MouseBiteLabs/Genesis-Cartridges/README.md

# Genesis-Cartridges
A collection of Genesis/Mega Drive cartridge circuit boards
