MouseBiteLabs/Genesis-Cartridges/Advanced Flash/schematic_1-2.pdf

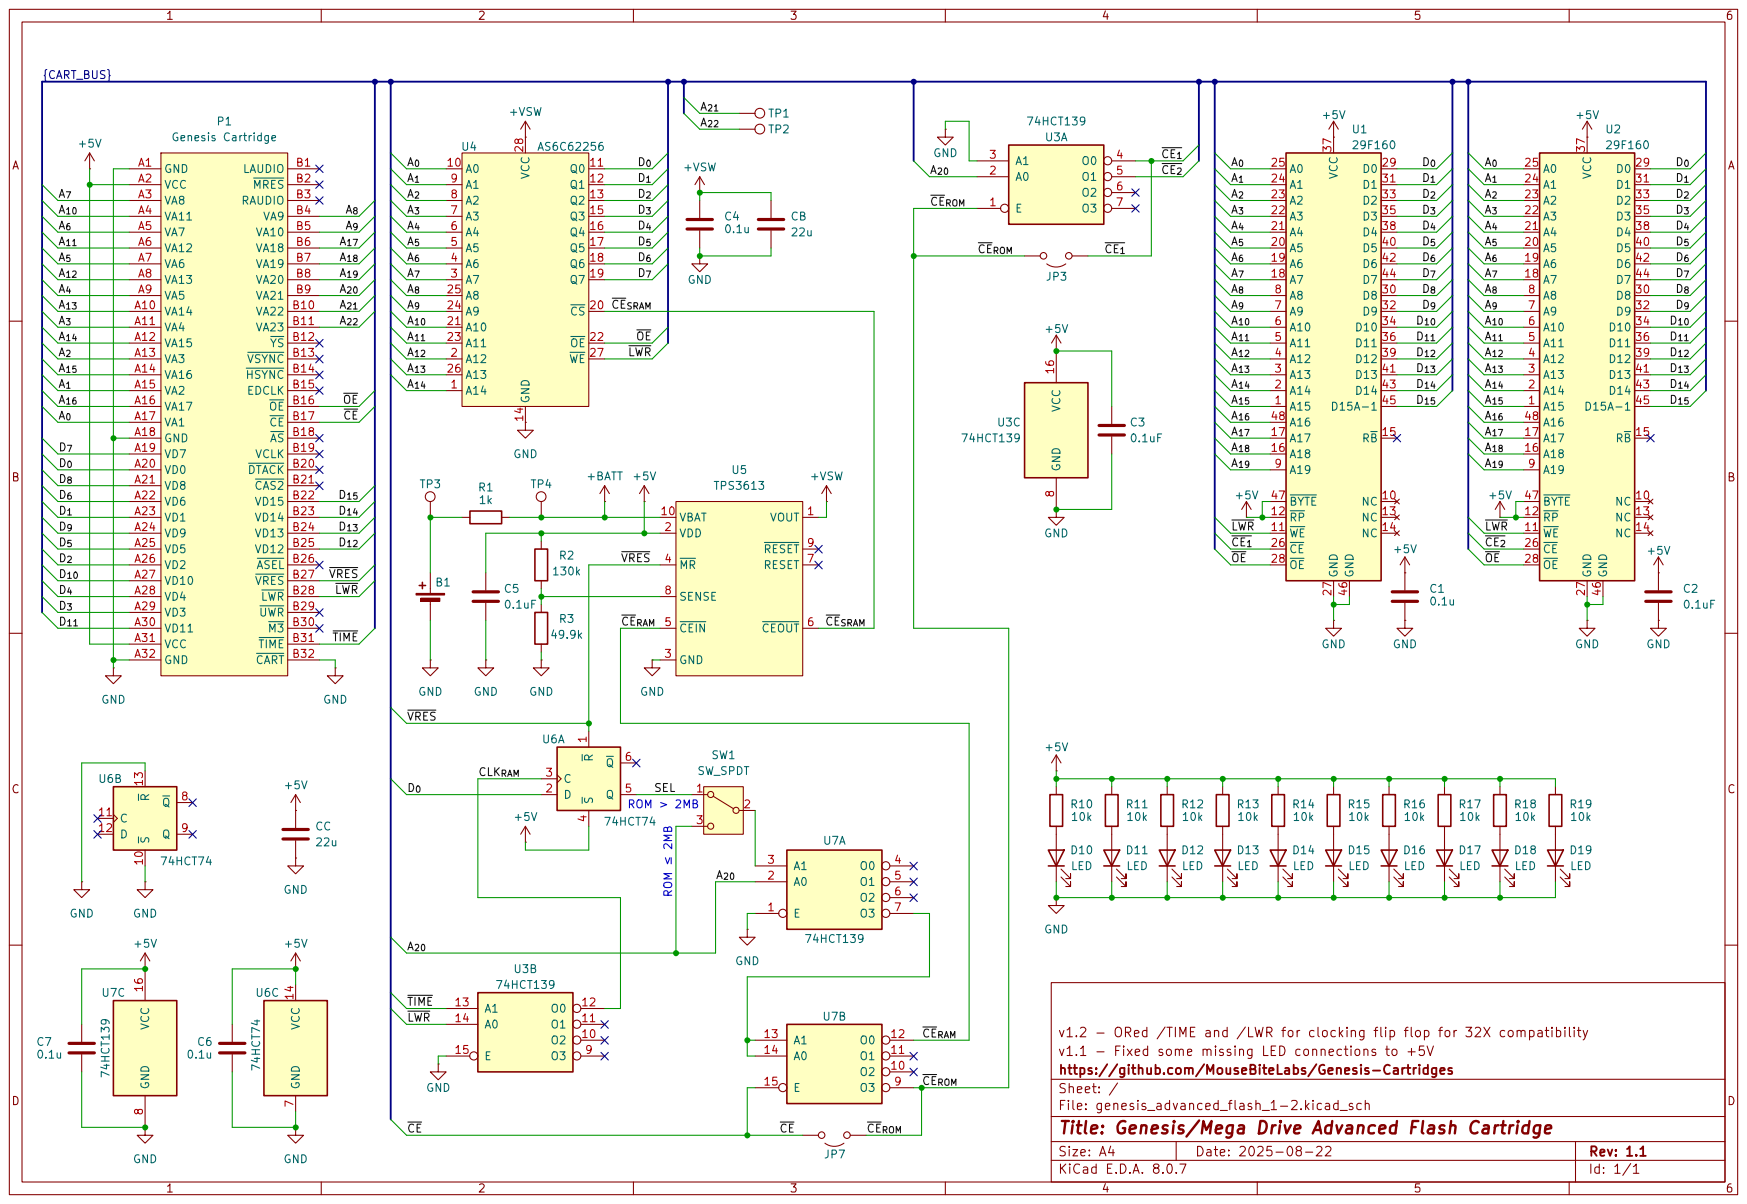
[picture p1: page 1]
