MouseBiteLabs/Genesis-Cartridges/Advanced UV/schematic.pdf

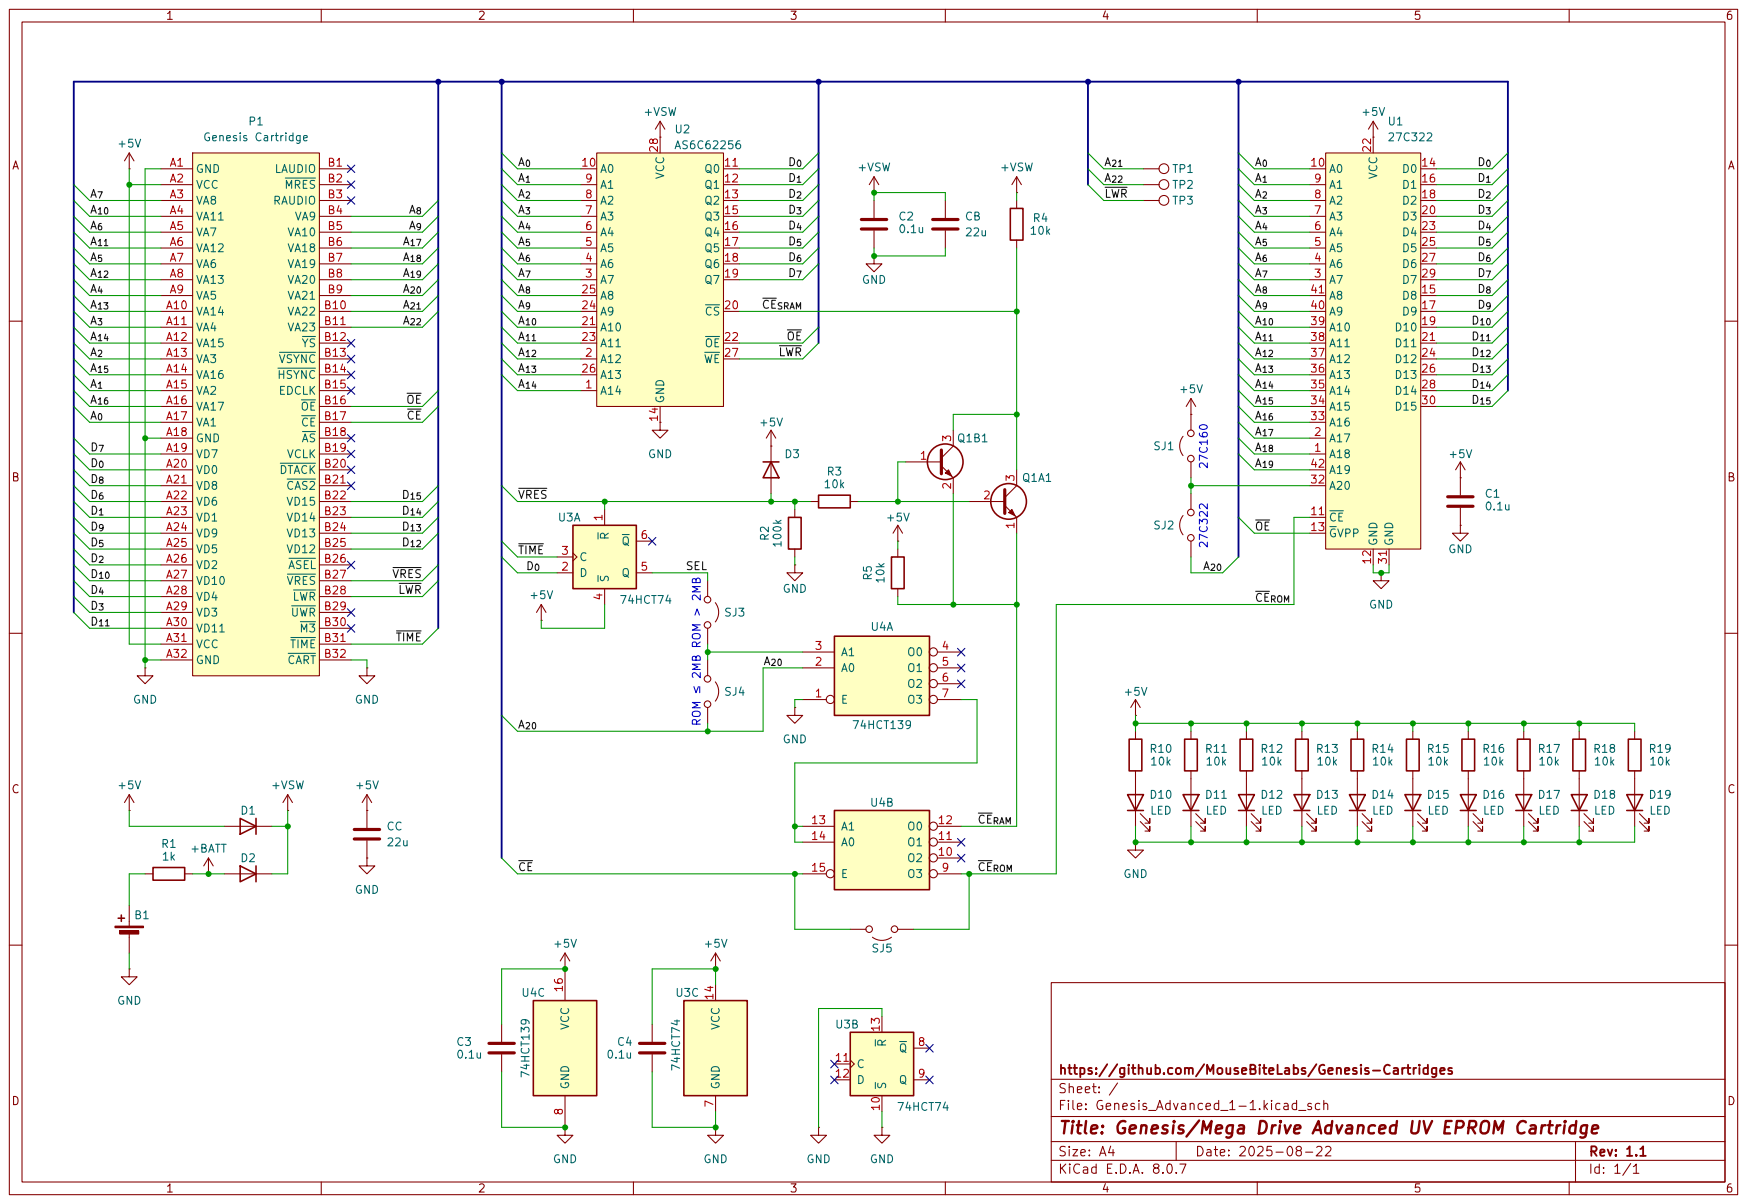
[picture p2: page 1]
