MouseBiteLabs/Genesis-Cartridges/Advanced Flash/schematic_1-1.pdf

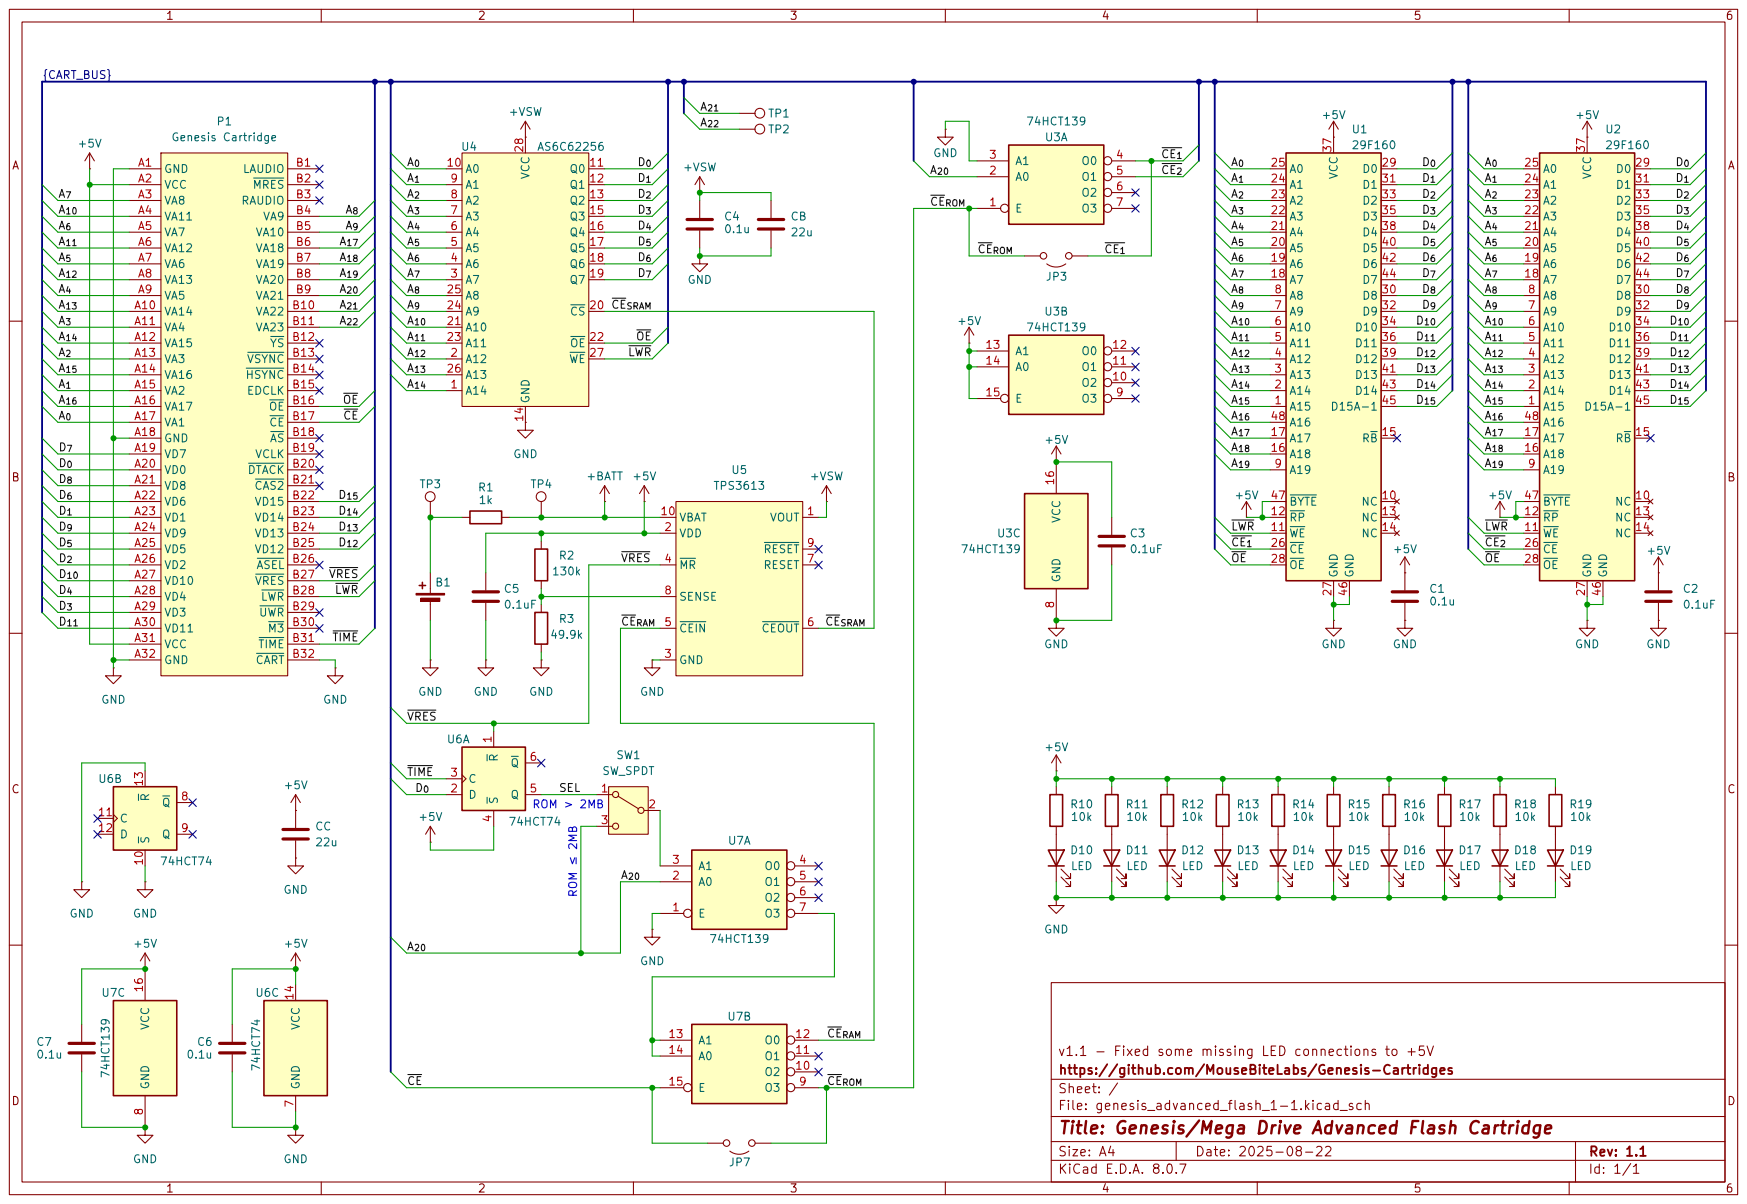
[picture p3: page 1]
