MouseBiteLabs/Genesis-Cartridges/Advanced Flash/genesis_advanced_flash_1-2.kicad_pcb

## KiCad design Advanced Flash/genesis_advanced_flash_1-2.kicad_pcb (2025-10-01)

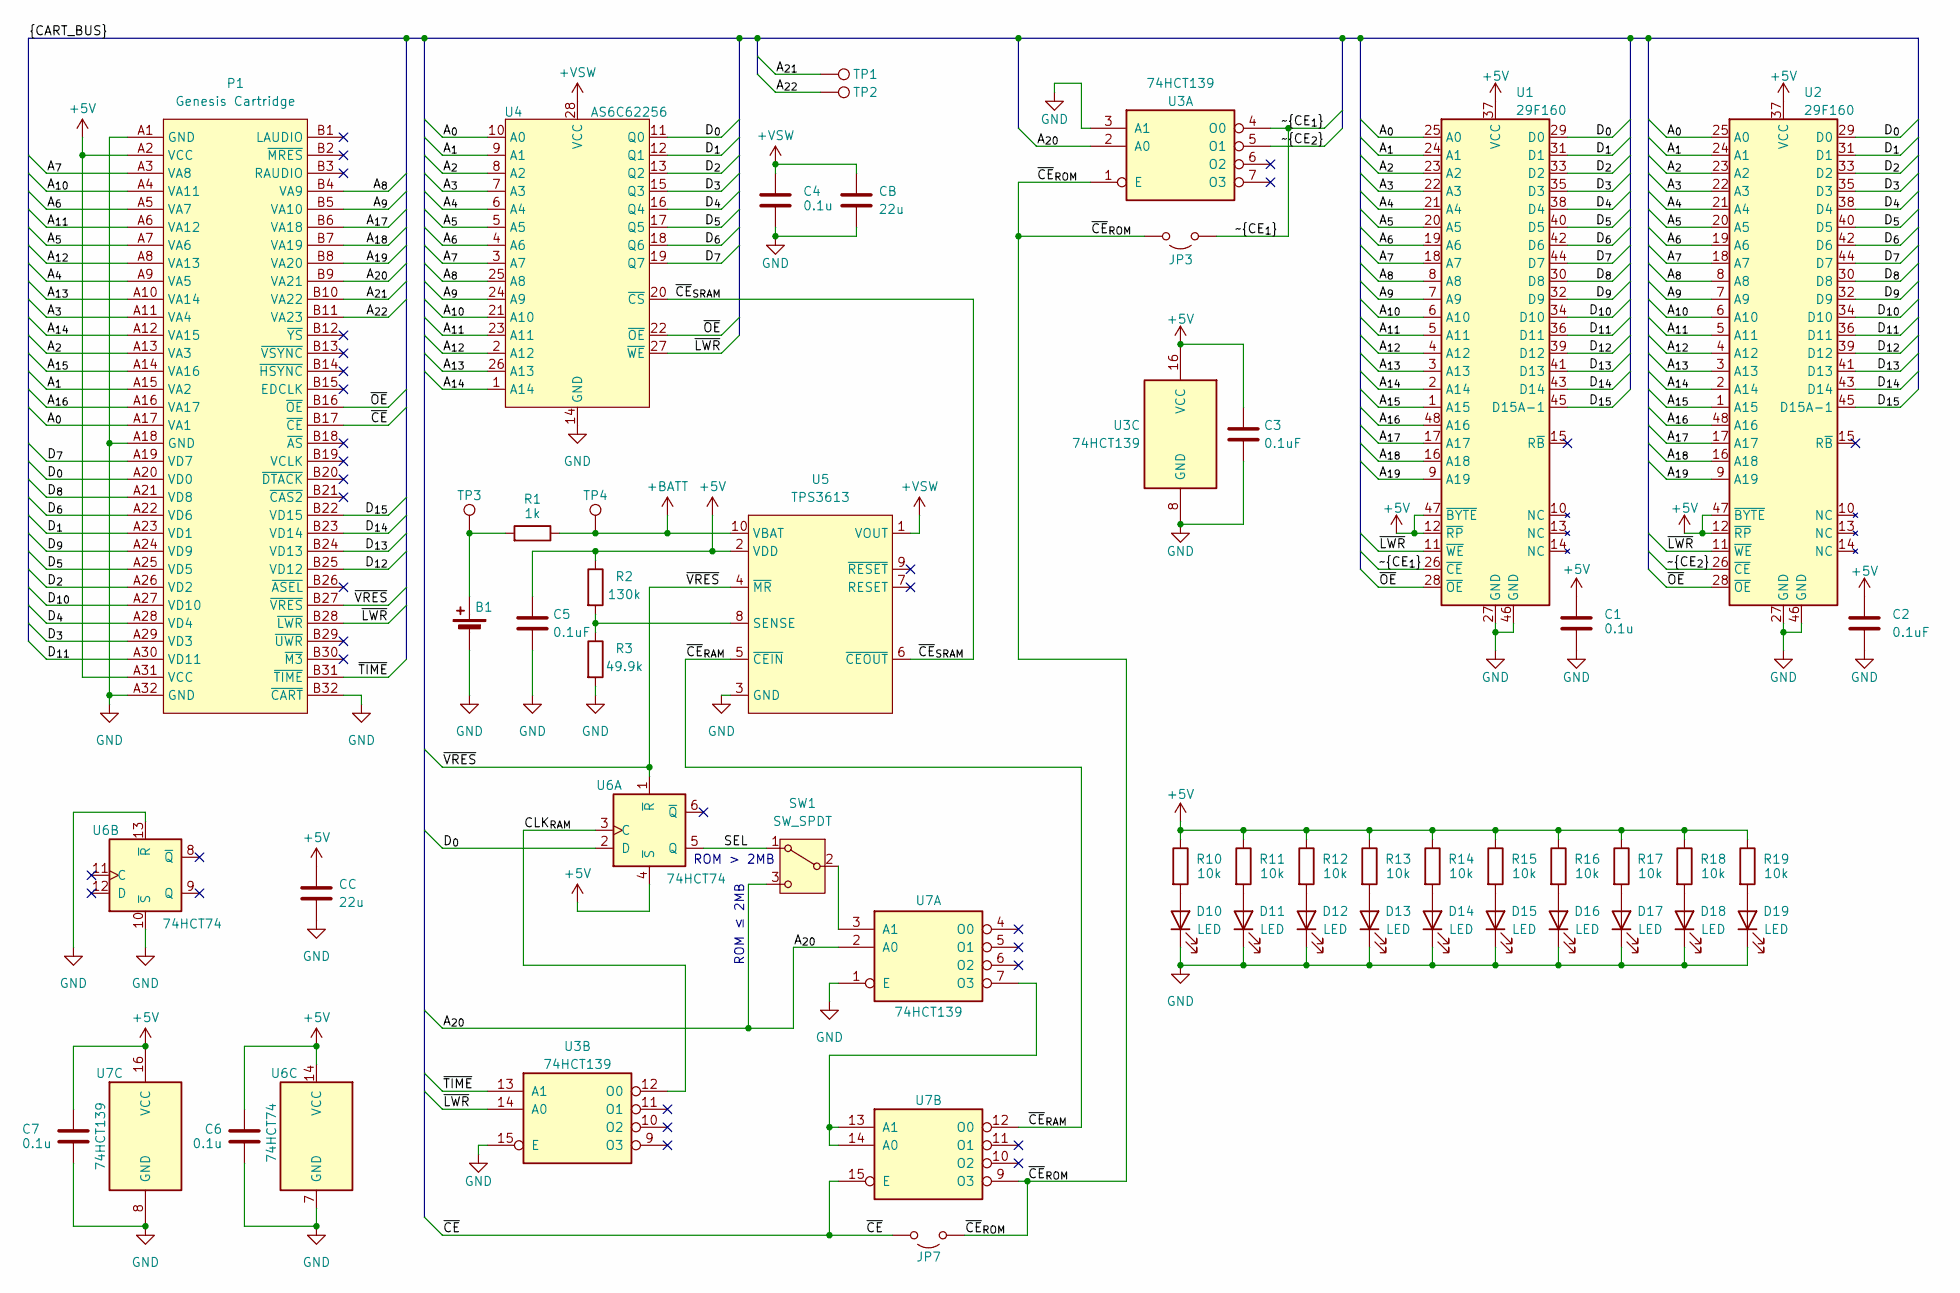
[picture p4: schematic genesis_advanced_flash_1-2.kicad_sch, Genesis/Mega Drive Advanced Flash Cartridge]

Parts:
B1: CR2025; COIN_CELL
C1, C4, C6, C7: 0.1u; C_0603_1608Metric_Boxed
C2, C3, C5: 0.1uF; C_0603_1608Metric_Boxed
CB: 22u; C_1206_3216Metric_Boxed
CC: 22u; C_1206_3216Metric_Boxed
D10, D11, D12, D13, D14, D15, D16, D17, D18, D19: LED; LED_0603_1608Metric_Pad1.05x0.95mm_HandSolder
JP3, JP7: Jumper_2_Open; SJ
P1: Genesis Cartridge; GENESIS_CART
R1: 1k; R_0603_1608Metric_Boxed
R2: 130k; R_0603_1608Metric_Boxed
R3: 49.9k; R_0603_1608Metric_Boxed
R10, R11, R12, R13, R14, R15, R16, R17, R18, R19: 10k; R_0603_1608Metric_Boxed
SW1: SW_SPDT; CAS120B
TP1, TP2, TP3, TP4: TPB1,27; TestPoint_Pad_D1.0mm
U1, U2: 29F160; TSOP-I-48_18.4x12mm_P0.5mm
U3, U7: 74HCT139; TSSOP-16_4.4x5mm_P0.65mm
U4: AS6C62256; SO28
U5: TPS3613; MSOP-10_3x3mm_P0.5mm
U6: 74HCT74; TSSOP-14_4.4x5mm_P0.65mm

Connections:
+5V: C1.1, C2.1, C3.1, C5.1, C6.1, C7.1, CC.1, P1.A2 (VCC), P1.A31 (VCC), R2.1, R10.1, R11.1, R12.1, R13.1, R14.1, R15.1, R16.1, R17.1, R18.1, R19.1, U1.12 (~RP), U1.37 (VCC), U1.47 (~BYTE), U2.12 (~RP), U2.37 (VCC), U2.47 (~BYTE), U3.16 (VCC), U5.2 (VDD), U6.4 (~S), U6.14 (VCC), U7.16 (VCC)
+BATT: R1.1, TP4.1, U5.10 (VBAT)
+VSW: C4.1, CB.1, U4.28 (VCC), U5.1 (VOUT)
/A_{0}: P1.A17 (VA1), U1.25 (A0), U2.25 (A0), U4.10 (A0)
/A_{1}: P1.A15 (VA2), U1.24 (A1), U2.24 (A1), U4.9 (A1)
/A_{2}: P1.A13 (VA3), U1.23 (A2), U2.23 (A2), U4.8 (A2)
/A_{3}: P1.A11 (VA4), U1.22 (A3), U2.22 (A3), U4.7 (A3)
/A_{4}: P1.A9 (VA5), U1.21 (A4), U2.21 (A4), U4.6 (A4)
/A_{5}: P1.A7 (VA6), U1.20 (A5), U2.20 (A5), U4.5 (A5)
/A_{6}: P1.A5 (VA7), U1.19 (A6), U2.19 (A6), U4.4 (A6)
/A_{7}: P1.A3 (VA8), U1.18 (A7), U2.18 (A7), U4.3 (A7)
/A_{8}: P1.B4 (VA9), U1.8 (A8), U2.8 (A8), U4.25 (A8)
/A_{9}: P1.B5 (VA10), U1.7 (A9), U2.7 (A9), U4.24 (A9)
/A_{10}: P1.A4 (VA11), U1.6 (A10), U2.6 (A10), U4.21 (A10)
/A_{11}: P1.A6 (VA12), U1.5 (A11), U2.5 (A11), U4.23 (A11)
/A_{12}: P1.A8 (VA13), U1.4 (A12), U2.4 (A12), U4.2 (A12)
/A_{13}: P1.A10 (VA14), U1.3 (A13), U2.3 (A13), U4.26 (A13)
/A_{14}: P1.A12 (VA15), U1.2 (A14), U2.2 (A14), U4.1 (A14)
/A_{15}: P1.A14 (VA16), U1.1 (A15), U2.1 (A15)
/A_{16}: P1.A16 (VA17), U1.48 (A16), U2.48 (A16)
/A_{17}: P1.B6 (VA18), U1.17 (A17), U2.17 (A17)
/A_{18}: P1.B7 (VA19), U1.16 (A18), U2.16 (A18)
/A_{19}: P1.B8 (VA20), U1.9 (A19), U2.9 (A19)
/A_{20}: P1.B9 (VA21), SW1.3 (C), U3.2 (A0), U7.2 (A0)
/A_{21}: P1.B10 (VA22), TP1.1
/A_{22}: P1.B11 (VA23), TP2.1
/CLK_{RAM}: U3.12 (O0), U6.3 (C)
/D_{0}: P1.A20 (VD0), U1.29 (D0), U2.29 (D0), U4.11 (Q0), U6.2 (D)
/D_{1}: P1.A23 (VD1), U1.31 (D1), U2.31 (D1), U4.12 (Q1)
/D_{2}: P1.A26 (VD2), U1.33 (D2), U2.33 (D2), U4.13 (Q2)
/D_{3}: P1.A29 (VD3), U1.35 (D3), U2.35 (D3), U4.15 (Q3)
/D_{4}: P1.A28 (VD4), U1.38 (D4), U2.38 (D4), U4.16 (Q4)
/D_{5}: P1.A25 (VD5), U1.40 (D5), U2.40 (D5), U4.17 (Q5)
/D_{6}: P1.A22 (VD6), U1.42 (D6), U2.42 (D6), U4.18 (Q6)
/D_{7}: P1.A19 (VD7), U1.44 (D7), U2.44 (D7), U4.19 (Q7)
/D_{8}: P1.A21 (VD8), U1.30 (D8), U2.30 (D8)
/D_{9}: P1.A24 (VD9), U1.32 (D9), U2.32 (D9)
/D_{10}: P1.A27 (VD10), U1.34 (D10), U2.34 (D10)
/D_{11}: P1.A30 (VD11), U1.36 (D11), U2.36 (D11)
/D_{12}: P1.B25 (VD12), U1.39 (D12), U2.39 (D12)
/D_{13}: P1.B24 (VD13), U1.41 (D13), U2.41 (D13)
/D_{14}: P1.B23 (VD14), U1.43 (D14), U2.43 (D14)
/D_{15}: P1.B22 (VD15), U1.45 (D15A-1), U2.45 (D15A-1)
/SEL: SW1.1 (A), U6.5 (Q)
/~CE_{1}: JP3.2 (B), U1.26 (~CE), U3.4 (O0)
/~CE_{2}: U2.26 (~CE), U3.5 (O1)
/~CE: JP7.1 (A), P1.B17 (~CE), U7.15 (E)
/~CE_{RAM}: U5.5 (~CEIN), U7.12 (O0)
/~CE_{ROM}: JP3.1 (A), JP7.2 (B), U3.1 (E), U7.9 (O3)
/~CE_{SRAM}: U4.20 (~CS), U5.6 (~CEOUT)
/~LWR: P1.B28 (~LWR), U1.11 (~WE), U2.11 (~WE), U3.14 (A0), U4.27 (~WE)
/~OE: P1.B16 (~OE), U1.28 (~OE), U2.28 (~OE), U4.22 (~OE)
/~TIME: P1.B31 (~TIME), U3.13 (A1)
/~VRES: P1.B27 (~VRES), U5.4 (~MR), U6.1 (~R)
GND: B1.2 (-), C1.2, C2.2, C3.2, C4.2, C5.2, C6.2, C7.2, CB.2, CC.2, D10.1 (K), D11.1 (K), D12.1 (K), D13.1 (K), D14.1 (K), D15.1 (K), D16.1 (K), D17.1 (K), D18.1 (K), D19.1 (K), P1.A1 (GND), P1.A18 (GND), P1.A32 (GND), P1.B32 (~CART), R3.2, U1.27 (GND), U1.46 (GND), U2.27 (GND), U2.46 (GND), U3.3 (A1), U3.8 (GND), U3.15 (E), U4.14 (GND), U5.3 (GND), U6.7 (GND), U6.10 (~S), U6.13 (~R), U7.1 (E), U7.8 (GND)
unnamed: B1.1 (+), R1.2, TP3.1
unnamed: D10.2 (A), R10.2
unnamed: D11.2 (A), R11.2
unnamed: D12.2 (A), R12.2
unnamed: D13.2 (A), R13.2
unnamed: D14.2 (A), R14.2
unnamed: D15.2 (A), R15.2
unnamed: D16.2 (A), R16.2
unnamed: D17.2 (A), R17.2
unnamed: D18.2 (A), R18.2
unnamed: D19.2 (A), R19.2
unnamed: SW1.2 (B), U7.3 (A1)
unnamed: R2.2, R3.1, U5.8 (SENSE)
unnamed: U7.7 (O3), U7.13 (A1), U7.14 (A0)

Notes on the sheet:
ROM ≤ 2MB
ROM > 2MB

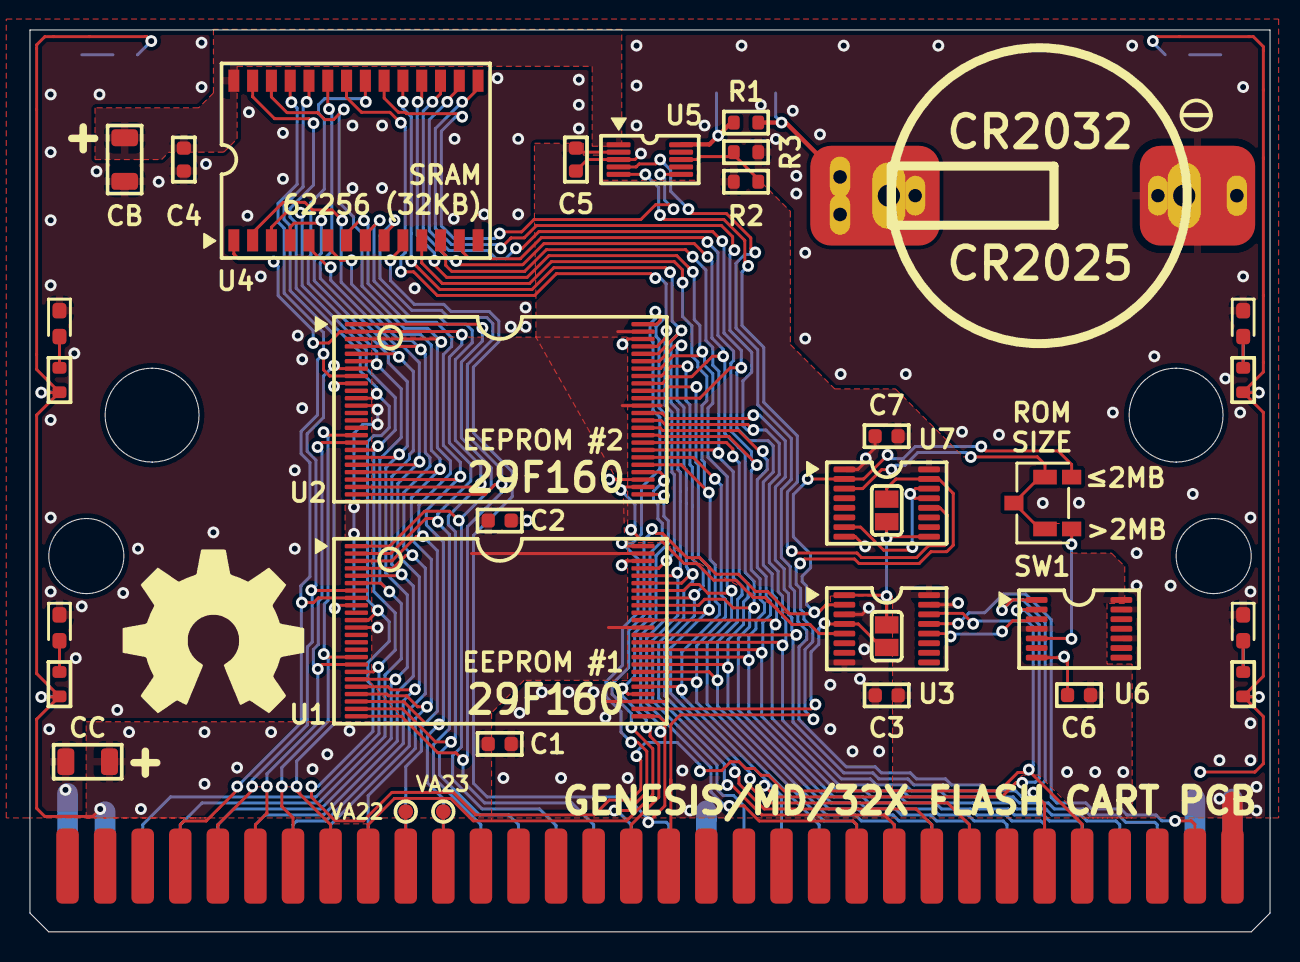
[picture p5: board genesis_advanced_flash_1-2.kicad_pcb from above]

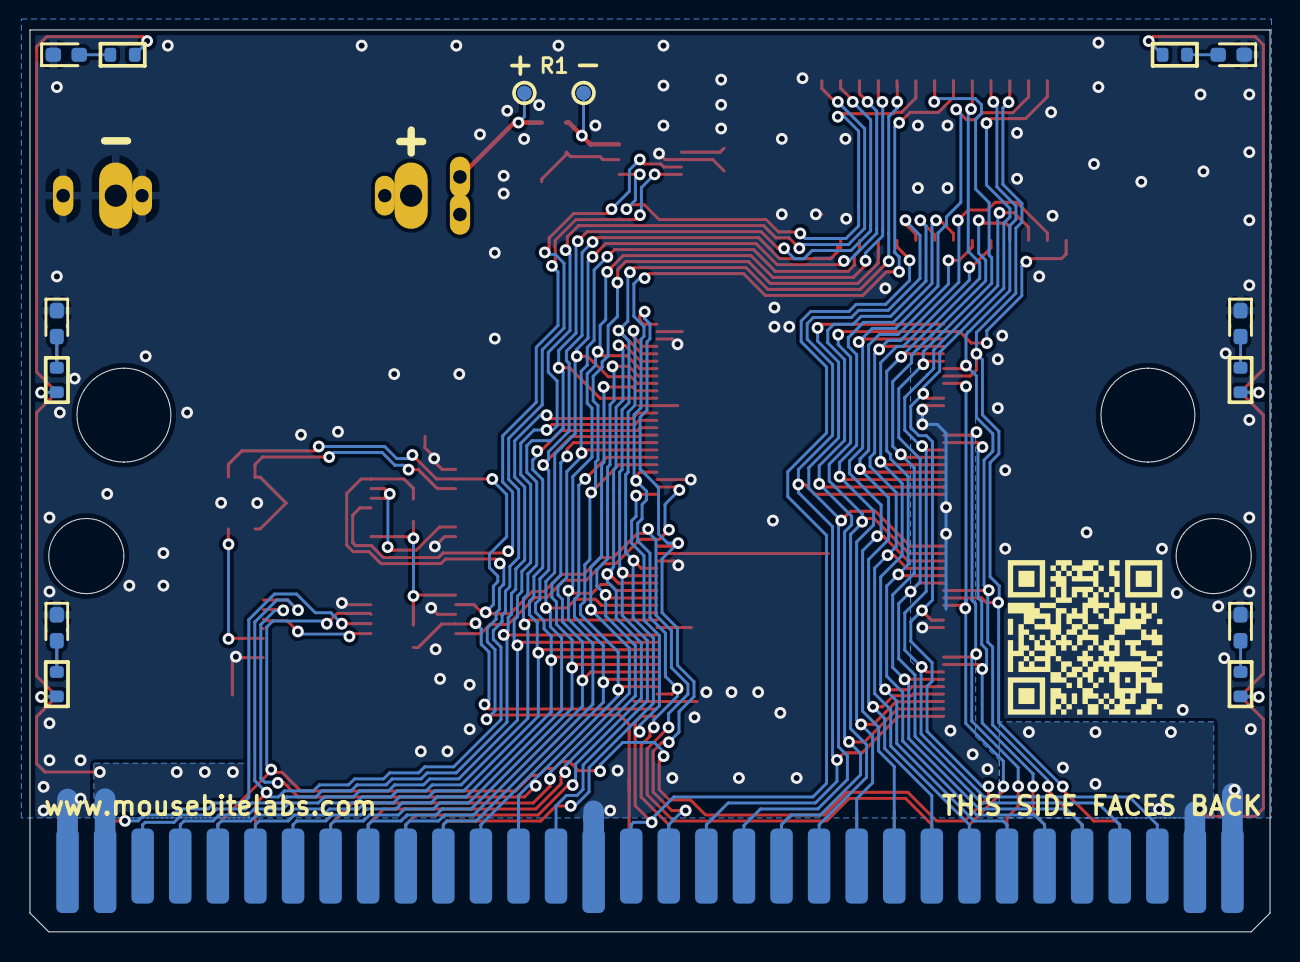
[picture p6: board genesis_advanced_flash_1-2.kicad_pcb from below]

Board: 2 copper layers, 83.8 x 61.0 mm, 48 parts (14 on the bottom side), 69 nets.
