MouseBiteLabs/Genesis-Cartridges/Advanced UV/Genesis_Advanced_UV_1-1.kicad_pcb

## KiCad design Advanced UV/Genesis_Advanced_UV_1-1.kicad_pcb (2025-08-23)

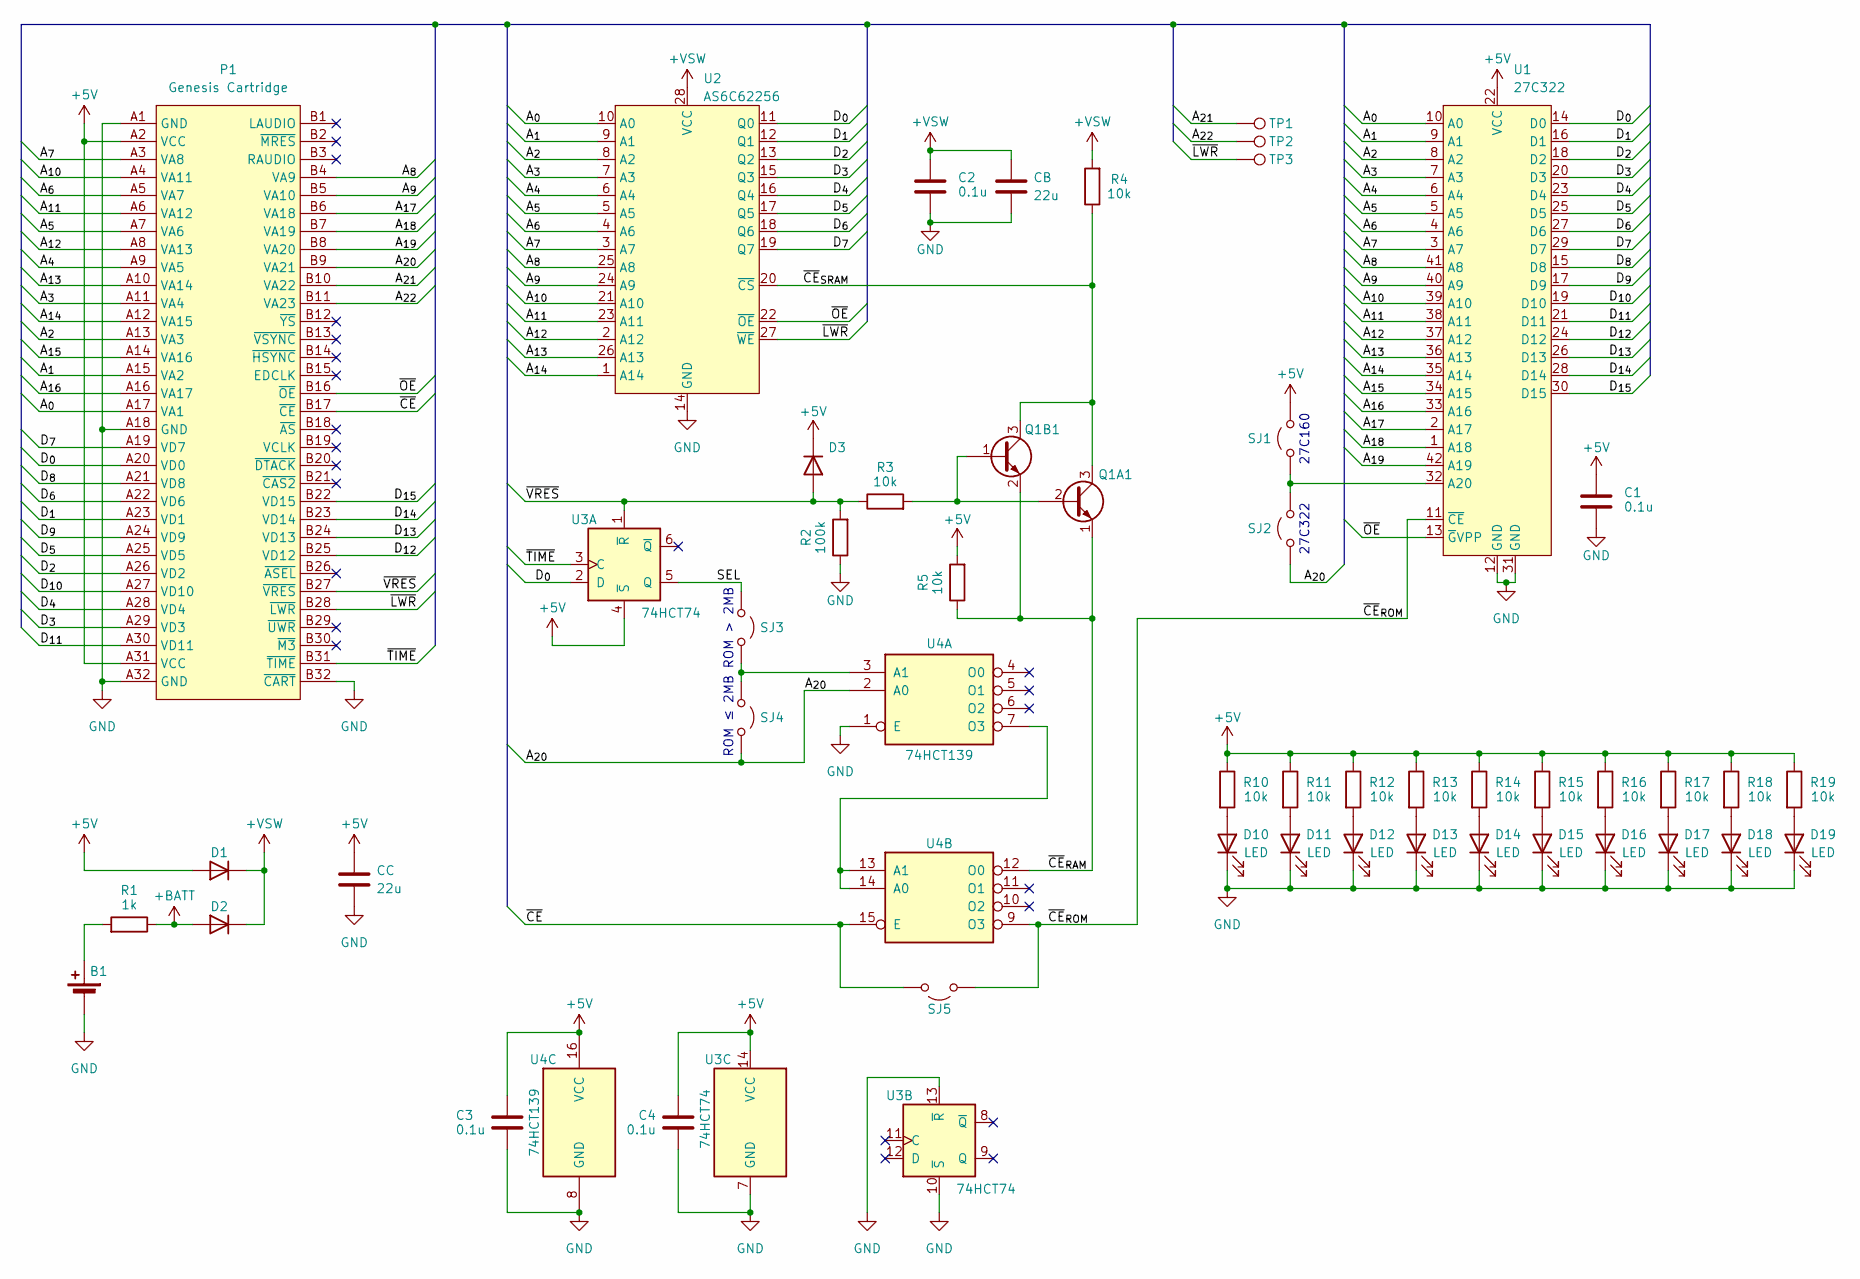
[picture p7: schematic Genesis_Advanced_UV_1-1.kicad_sch, Genesis/Mega Drive Advanced UV EPROM Cartridge]

Parts:
B1: CR2025; COIN_CELL
C1, C2, C3, C4: 0.1u; THT_SMT_0803_SHORT
CB: 22u; CP_Radial_D5.0mm_P2.50mm
CC: 22u; CP_Radial_D5.0mm_P2.50mm
D1, D2, D3: D; DIODE_THT_SMT
D10, D11, D12, D13, D14, D15, D16, D17, D18, D19: LED; LED_0603_1608Metric_Pad1.05x0.95mm_HandSolder
P1: Genesis Cartridge; GENESIS_CART
Q1A1: 2N3904; TO-92L_Inline_Wide
Q1B1: MMBT3904; SOT-23
R1: 1k; THT_SMT_0803
R2: 100k; THT_SMT_0803
R3, R4, R5: 10k; THT_SMT_0803
R10, R11, R12, R13, R14, R15, R16, R17, R18, R19: 10k; R_0603_1608Metric_Boxed
SJ1, SJ2, SJ3, SJ4, SJ5: Jumper_2_Open; SJ
TP1, TP2, TP3: TPB1,27; TestPoint_THTPad_D1.5mm_Drill0.7mm
U1: 27C322; DIP-42_W15.24mm
U2: AS6C62256; DIP-28_W15.24mm_DUAL
U3: 74HCT74; DIP-14_W7.62mm
U4: 74HCT139; DIP-16_W7.62mm

Connections:
+5V: C1.1, C3.1, C4.1, CC.1, D1.2 (A), D3.1 (K), P1.A2 (VCC), P1.A31 (VCC), R5.2, R10.1, R11.1, R12.1, R13.1, R14.1, R15.1, R16.1, R17.1, R18.1, R19.1, SJ1.2 (B), U1.22 (VCC), U3.4 (~S), U3.14 (VCC), U4.16 (VCC)
+BATT: D2.2 (A), R1.1
+VSW: C2.1, CB.1, D1.1 (K), D2.1 (K), R4.2, U2.28 (VCC)
/A_{0}: P1.A17 (VA1), U1.10 (A0), U2.10 (A0)
/A_{1}: P1.A15 (VA2), U1.9 (A1), U2.9 (A1)
/A_{2}: P1.A13 (VA3), U1.8 (A2), U2.8 (A2)
/A_{3}: P1.A11 (VA4), U1.7 (A3), U2.7 (A3)
/A_{4}: P1.A9 (VA5), U1.6 (A4), U2.6 (A4)
/A_{5}: P1.A7 (VA6), U1.5 (A5), U2.5 (A5)
/A_{6}: P1.A5 (VA7), U1.4 (A6), U2.4 (A6)
/A_{7}: P1.A3 (VA8), U1.3 (A7), U2.3 (A7)
/A_{8}: P1.B4 (VA9), U1.41 (A8), U2.25 (A8)
/A_{9}: P1.B5 (VA10), U1.40 (A9), U2.24 (A9)
/A_{10}: P1.A4 (VA11), U1.39 (A10), U2.21 (A10)
/A_{11}: P1.A6 (VA12), U1.38 (A11), U2.23 (A11)
/A_{12}: P1.A8 (VA13), U1.37 (A12), U2.2 (A12)
/A_{13}: P1.A10 (VA14), U1.36 (A13), U2.26 (A13)
/A_{14}: P1.A12 (VA15), U1.35 (A14), U2.1 (A14)
/A_{15}: P1.A14 (VA16), U1.34 (A15)
/A_{16}: P1.A16 (VA17), U1.33 (A16)
/A_{17}: P1.B6 (VA18), U1.2 (A17)
/A_{18}: P1.B7 (VA19), U1.1 (A18)
/A_{19}: P1.B8 (VA20), U1.42 (A19)
/A_{20}: P1.B9 (VA21), SJ2.1 (A), SJ4.1 (A), U4.2 (A0)
/A_{21}: P1.B10 (VA22), TP1.1
/A_{22}: P1.B11 (VA23), TP2.1
/D_{0}: P1.A20 (VD0), U1.14 (D0), U2.11 (Q0), U3.2 (D)
/D_{1}: P1.A23 (VD1), U1.16 (D1), U2.12 (Q1)
/D_{2}: P1.A26 (VD2), U1.18 (D2), U2.13 (Q2)
/D_{3}: P1.A29 (VD3), U1.20 (D3), U2.15 (Q3)
/D_{4}: P1.A28 (VD4), U1.23 (D4), U2.16 (Q4)
/D_{5}: P1.A25 (VD5), U1.25 (D5), U2.17 (Q5)
/D_{6}: P1.A22 (VD6), U1.27 (D6), U2.18 (Q6)
/D_{7}: P1.A19 (VD7), U1.29 (D7), U2.19 (Q7)
/D_{8}: P1.A21 (VD8), U1.15 (D8)
/D_{9}: P1.A24 (VD9), U1.17 (D9)
/D_{10}: P1.A27 (VD10), U1.19 (D10)
/D_{11}: P1.A30 (VD11), U1.21 (D11)
/D_{12}: P1.B25 (VD12), U1.24 (D12)
/D_{13}: P1.B24 (VD13), U1.26 (D13)
/D_{14}: P1.B23 (VD14), U1.28 (D14)
/D_{15}: P1.B22 (VD15), U1.30 (D15)
/SEL: SJ3.2 (B), U3.5 (Q)
/~CE: P1.B17 (~CE), SJ5.1 (A), U4.15 (E)
/~CE_{RAM}: Q1A1.1 (E), Q1B1.2 (E), R5.1, U4.12 (O0)
/~CE_{ROM}: SJ5.2 (B), U1.11 (~CE), U4.9 (O3)
/~CE_{SRAM}: Q1A1.3 (C), Q1B1.3 (C), R4.1, U2.20 (~CS)
/~LWR: P1.B28 (~LWR), TP3.1, U2.27 (~WE)
/~OE: P1.B16 (~OE), U1.13 (~GVPP), U2.22 (~OE)
/~TIME: P1.B31 (~TIME), U3.3 (C)
/~VRES: D3.2 (A), P1.B27 (~VRES), R2.2, R3.1, U3.1 (~R)
GND: B1.2 (-), C1.2, C2.2, C3.2, C4.2, CB.2, CC.2, D10.1 (K), D11.1 (K), D12.1 (K), D13.1 (K), D14.1 (K), D15.1 (K), D16.1 (K), D17.1 (K), D18.1 (K), D19.1 (K), P1.A1 (GND), P1.A18 (GND), P1.A32 (GND), P1.B32 (~CART), R2.1, U1.12 (GND), U1.31 (GND), U2.14 (GND), U3.7 (GND), U3.10 (~S), U3.13 (~R), U4.1 (E), U4.8 (GND)
unnamed: B1.1 (+), R1.2
unnamed: D10.2 (A), R10.2
unnamed: D11.2 (A), R11.2
unnamed: D12.2 (A), R12.2
unnamed: D13.2 (A), R13.2
unnamed: D14.2 (A), R14.2
unnamed: D15.2 (A), R15.2
unnamed: D16.2 (A), R16.2
unnamed: D17.2 (A), R17.2
unnamed: D18.2 (A), R18.2
unnamed: D19.2 (A), R19.2
unnamed: Q1A1.2 (B), Q1B1.1 (B), R3.2
unnamed: SJ1.1 (A), SJ2.2 (B), U1.32 (A20)
unnamed: SJ3.1 (A), SJ4.2 (B), U4.3 (A1)
unnamed: U4.7 (O3), U4.13 (A1), U4.14 (A0)

Notes on the sheet:
ROM ≤ 2MB
27C322
ROM > 2MB
27C160

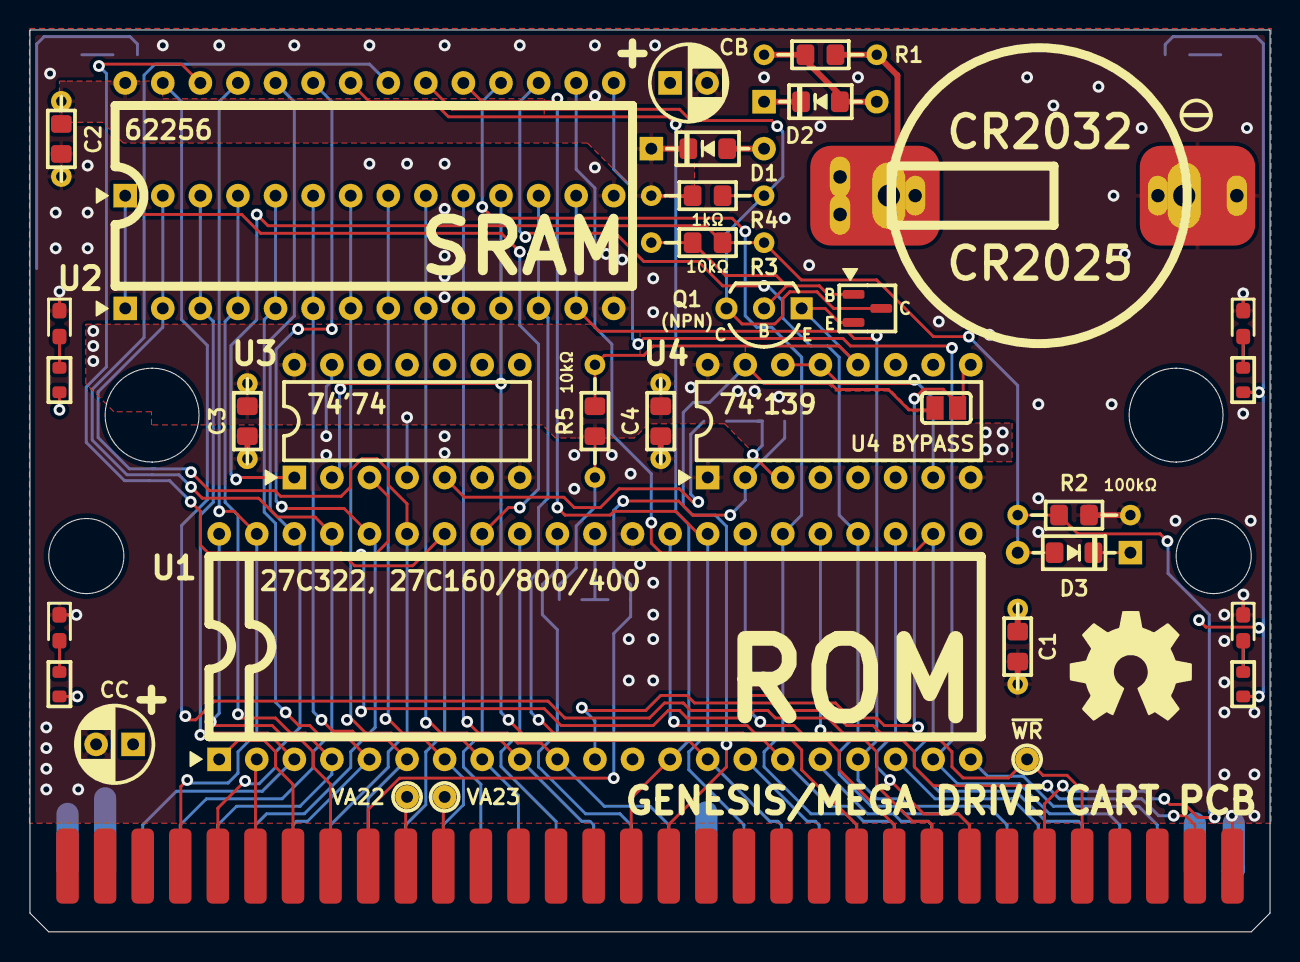
[picture p8: board Genesis_Advanced_UV_1-1.kicad_pcb from above]

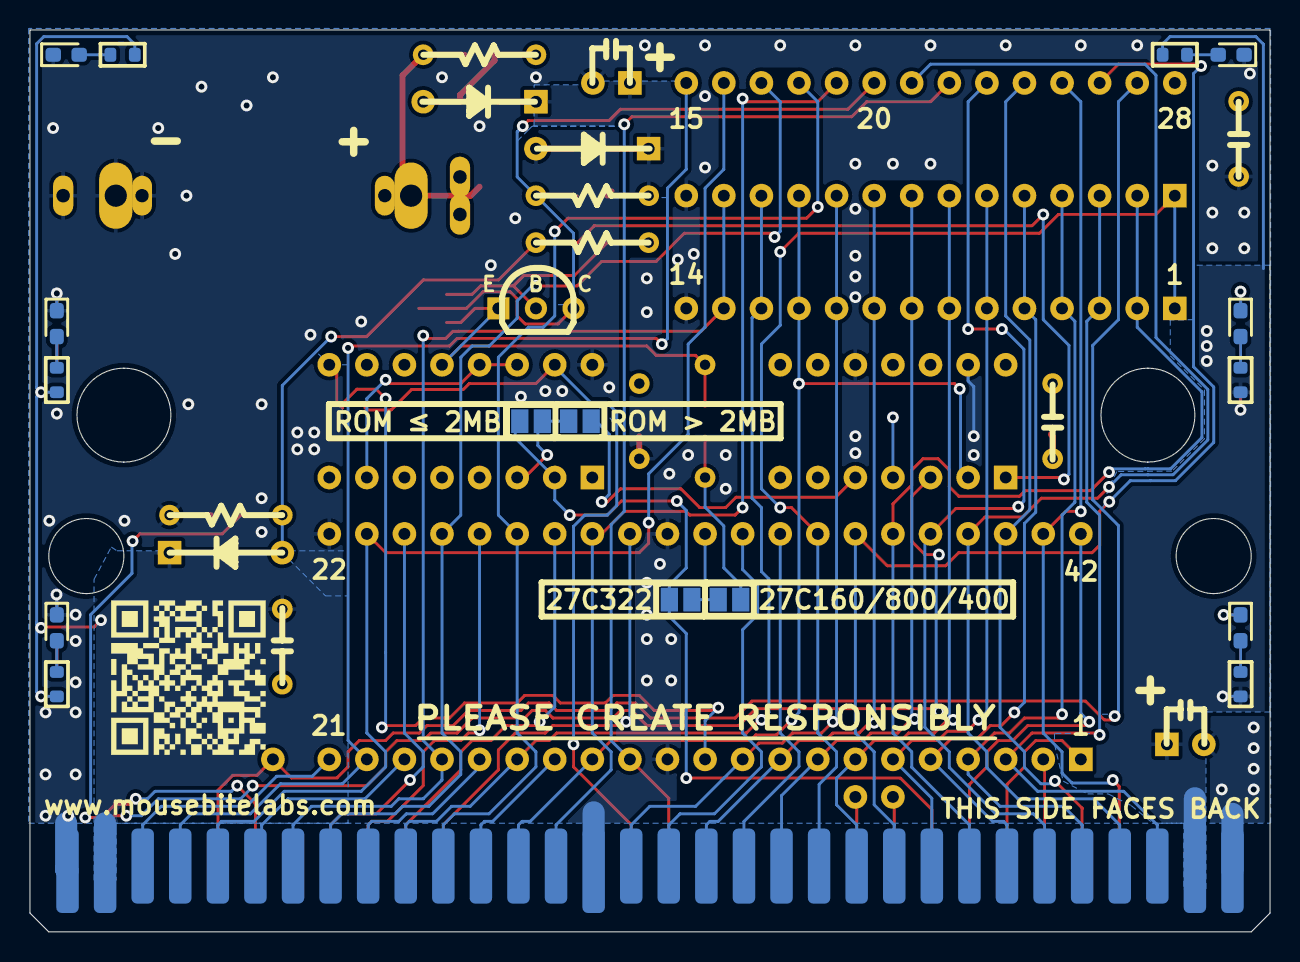
[picture p9: board Genesis_Advanced_UV_1-1.kicad_pcb from below]

Board: 2 copper layers, 83.8 x 61.0 mm, 50 parts (16 on the bottom side), 67 nets.
